Esther-365/LoRa_Puck/LoRa_BOM.xlsx

Part | Qty | Unit ($) | Total ($) | Vendor
U.FL Connector | 1 | $1.67 | $1.67 | DigiKey (https://www.digikey.com/en/products/detail/hirose-electric-co-ltd/U-FL-R-SMT-1-10/2391570)
Antenna | 1 | $9.99 | $9.99 | Amazon (https://www.amazon.com/dp/B0F8QLDMST)
100nF capacitor | 20 | $0.10 | $2.00 | DigiKey (https://www.digikey.com/en/products/detail/samsung-electro-mechanics/CL05B104KP5VPNC/20498482)
470NF Capacitor | 2 | $0.29 | $0.58 | DigiKey (https://www.digikey.com/en/products/detail/samsung-electro-mechanics/CL05Y474KP5VPJC/20532337)
3.3pF capacitor | 4 | $0.02 | $0.08 | DigiKey (https://www.digikey.com/en/products/detail/murata-electronics/GRM1555C1H3R3CA01D/3693848)
39pF capacitor | 2 | $0.04 | $0.08 | DigiKey (https://www.digikey.com/en/products/detail/kemet/C0402C390J5GACTU/411020)
1nF | 2 | $0.09 | $0.18 | DigiKey (https://www.digikey.com/en/products/detail/kemet/C0402C102K5RECTU/8643595)
47pFCapacitor | 3 | $0.04 | $0.12 | DigiKey (https://www.digikey.com/en/products/detail/murata-electronics/GCM1555C1H470JA16D/4903611)
47nF Capacitor | 2 | $0.09 | $0.18 | DigiKey (https://www.digikey.com/en/products/detail/kemet/C0402C473K3RECTU/8643594)
15pF | 4 | $0.03 | $0.12 | DigiKey (https://www.digikey.com/en/products/detail/murata-electronics/GRM1555C1H150JA01D/2791374)
1uF | 4 | $0.50 | $2.00 | Mouser (https://www.mouser.com/ProductDetail/KYOCERA-AVX/KGM05AR51A105KN)
10uF Capacitor | 5 | $0.10 | $0.50 | DigiKey (https://www.digikey.com/en/products/detail/murata-electronics/GRM155R60J106ME15D/5877401)
LED | 2 | $0.30 | $0.60 | DigiKey (https://www.digikey.com/en/products/detail/würth-elektronik/151051RS11000/4490012)
BLM15AX102SN1D | 3 | $0.10 | $0.30 | DigiKey (https://www.digikey.com/en/products/detail/murata-electronics/BLM15AX102SN1D/2256877)
0900FM15K0039 | 2 | $0.50 | $1.00 | DigiKey (https://www.digikey.com/en/products/detail/johanson-technology-inc/0900FM15K0039001E/16639329)
USBC Receptacle | 1 | $0.80 | $0.80 | DigiKey (https://www.digikey.com/en/products/detail/gct/USB4105-GF-A/11198441)
15uH inductor | 3 | $0.10 | $0.30 | DigiKey (https://www.digikey.com/en/products/detail/tdk/MLZ2012M150WT000/2465154)
9.1nH inductor | 3 | $0.20 | $0.60 | DigiKey (https://www.digikey.com/en/products/detail/murata-electronics/LQW15AN9N1G8ZD/6799034)
47nH inductor | 3 | $0.20 | $0.60 | DigiKey (https://www.digikey.com/en/products/detail/murata-electronics/LQW15AN47NJ00D/584363)
100 ohms Resistor | 3 | $0.04 | $0.12 | DigiKey (https://www.digikey.com/en/products/detail/vishay-dale/CRCW0402100RFKED/1177893)
1K Resistor | 3 | $0.03 | $0.09 | DigiKey (https://www.digikey.com/en/products/detail/panasonic-industry/ERJ-2RKF1001X/79729)
10K Resistor | 3 | $0.02 | $0.06 | DigiKey (https://www.digikey.com/en/products/detail/stackpole-electronics-inc/RMCF0805FT10K0/1760676)
27.4 Resistor | 6 | $0.05 | $0.30 | DigiKey (https://www.digikey.com/en/products/detail/panasonic-industry/ERJ-2RKF27R0X/1746179)
5.1k resistor | 6 | $0.30 | $1.80 | DigiKey (https://www.digikey.com/en/products/detail/yageo/RC0402FR-075K1L/726624)
330 Resistor | 2 | $0.03 | $0.06 | DigiKey (https://www.digikey.com/en/products/detail/yageo/RC0402FR-07330RL/726594)
SX1262IMLTRT | 1 | $9.30 | $9.30 | Amazon (https://www.amazon.com/SX1262IMLTRT-SX1262-QFN-24-Global-Frequency/dp/B0D1VVR788/ref=sr_1_2)
RP2040 | 2 | $0.80 | $1.60 | DigiKey (https://www.digikey.com/en/products/detail/raspberry-pi/SC0914-13/14306010)
PE4259 | 2 | $1.20 | $2.40 | LCSC (https://www.lcsc.com/product-detail/C470892.html?s_z=n_q_PE4259)
W25Q128JVS | 1 | $5.80 | $5.80 | DigiKey (https://www.digikey.com/en/products/detail/winbond-electronics/W25Q128JVSIQ-TR/5803944)
AP2112K-3.3 | 2 | $0.28 | $0.56 | DigiKey (https://www.digikey.com/en/products/detail/diodes-incorporated/AP2112K-3-3TRG1/4470746)
32MHz Crystal | 2 | $0.54 | $1.08 | DigiKey (https://www.digikey.com/en/products/detail/ecs-inc/ECS-320-10-33B-CKM-TR/8023144)
PCB | 1 | $8.00 | $8.00 | JLCPCB (https://cart.jlcpcb.com/quote)
12MHz Crystal | 2 | $0.70 | $1.40 | DigiKey (https://www.digikey.com/en/products/detail/abracon-llc/ABM8-272-T3/22472366)
Switches | 4 | $0.29 | $1.16 | DigiKey (https://www.digikey.com/en/products/detail/c-k/PTS636SM25SMTR-LFS/10071734)
Total | 107 |  | $55.43
Source: transcribed from the user's BOM screenshots; items that appeared in two screenshots are listed once. Total = Qty x Unit.
