Esther-365/LoRa_Puck/(commit log)

2026-11-08 Uploaded Schematic and PCB editor
    [LoRa.kicad_pcb, LoRa.kicad_sch]
2026-11-09 Enhance README with detailed component descriptions
    Expanded the README with detailed explanations about the LoRa device components, including the SX1262, USB-C connection, LED feature, and PCB routing changes.
2026-11-09 Update firmware details for SX1262 and SPI library
    Updated firmware section to reflect changes in the hardware component SX1262 and added a link to the SPI library.
2026-11-09 Add BOM link to README
    Added link to the Bill of Materials in the README.
2026-11-09 Update BOM file link from CSV to Excel
